jianweizou/count-display/FAE/计数器问题测试报告.docx

# 计数器问题测试报告

问题：外部表现是充电时，按键后OLED无任何显示

测试：

1、通过对测试样品进行充电测试，发现电路有140mA，并且伴随有充电IC（丝印LTH7）发热现象，怀疑是充电IC损坏；

2、 在购买一些TP4054充电IC后，进行替换后，所有测试样品都能正常充电；
3、 在2中替换后，有部分样品工作正常（标记B），有部分没有显示（标记A），电池电压均正常；
4、 对调工作正常和不正常的OLED后，结果依然是可以显示的OLED能显示，不能的依然不行；初步怀疑是OLED FPC折断。
