jianweizou/count-display/doc/计数器.pdf

# 佛珠計數器顯示介面

K 三 WA

# 開机劃面 1 ，顯示二秒然後自動跳到 2

1

2 中文 /ENGLISH 長短選定中文跳至 2-2 ，短按跳至 ENGLISH 長按選定 ENGLISH 跳至 3-2

# 2 中文顯示介面

2-2 | 2018/01/01 23:59 | 2018 閃爍，短按一下就跳 2019 年，長按 2 秒選定後跳至 月 01 按 一下就跳 02 ，長按 2 秒選定後跳至 日 01 按一下就跳 02 ，長按 2 秒選定後跳至 2-3
2-4 | 數字 / 藏文數字 長按選定數字 跳至 2-9 ，短按一下跳 藏文數字 長按 2 秒選定後跳至 2-
| 9 。

日期時間正確
是 / 否
2-3 | 長按選定 是 跳至 2-4 ，短按一下跳 否 長按 2 秒選定 否 跳至
| 2-2 ，

# 阿拉伯與 阿拉伯數字與藏文數字對照，請見最後一頁

# 2 中文顯示介面

2-9

# 歸零 是 / 否 重置 是 / 否

計數模式下， 3 秒內無動作，自動關閉屏目 , 五分鐘無動作， 整体待机到最小功秏。 在關閉屏目或待机下，按一下按鍵回復並點亮屏目，同步計數

加 1

2-14

2-13

2-12

2-11

# 計數模式下長按 12 秒不放會自動出現 重置 是 / 否 的劃面 長按 是 跳至 1 重新設置，短按跳至 否 長按選定 否 跳回

2-12.

計數模式下長按 5 秒不放會自動出現 歸零 是 / 否 的劃面， 長按選定 是 累計數歸零並跳至 2-9 ，短按跳 否 長按選定 否 跳回 2-12

2018/01/01
TOTAL:00001

2018/01/01
TOTAL:00002

計數開始，屏目顯示日期跟數字，從 0 開始每按一下跳 1 累計。

# 2 英文顯示介面

3-2 | 2018/01/01 | 2018 閃爍，按一下跳 2019 ，長按 2 秒選定後跳至 月 01 按一下就 跳 02 ，長按 2 秒選定後跳至 日 01 按一下就跳 02 ，長按 2 秒選定 後跳至 3-3
3-4 | NORMAL/TIBETAN | 長按選定 NORMAL 跳至 3-9 ，短按跳 TIBETAN ，長按 2 秒選定 TIBETAN 後跳至 3-9 。
3-3 | DATE YES/NO | 長按選定 YES 跳至 3-4 ， 短按跳 NO 長按 2 秒選定 NO 跳至 3-2 重新設定日期

# 2 英文顯示介面

2018/01/01

TOTAL:00001 3-9 | 計數開始，屏目顯示 日期跟數字，從 0 開始每按一下跳 1 累

計。

RESET COUNT
YES/NO

RESET DEVICE
YES/NO

計數模式下， 3 秒內無動作，並關閉屏目 , 五分鐘無動作，整 体待机到最小功秏。

在關閉屏目或待机下，按一下按鍵回復，出現屏目並計數加 1

3-14

3-13

3-12

3-11

2018/01/01
TOTAL:00002 | 計數下長按 5 秒不放會自動出現 RESET COUNT YES/NO 的
| 劃面，長按選定 YES 累計數歸零並跳至 3-9 ，短按跳 NO 長按選定 NO 跳回 3-12 計數下長按 12 秒不放會自動出現 RESET DEVICE YES/NO 的劃面 長按 YES 跳至 1 重新設置裝置，短按跳 NO 長

按選定 NO 跳回 2-12.

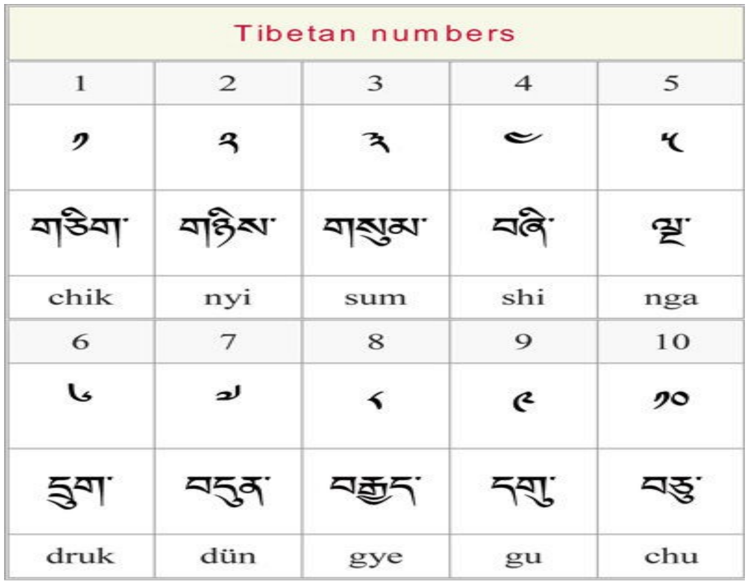
[picture p6: page 6]
