jianweizou/count-display/doc/Counter+ME+BOM+list+20180106.pptx

Mechanical Parts
BOM and material description

## Slide 2

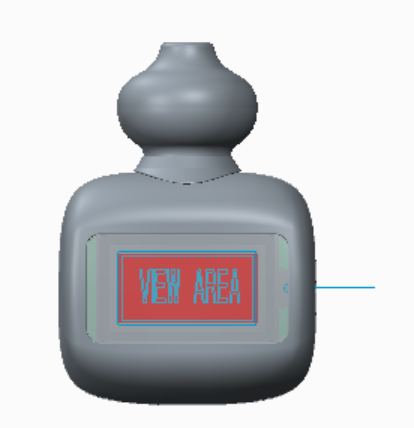
[picture p7: figure]
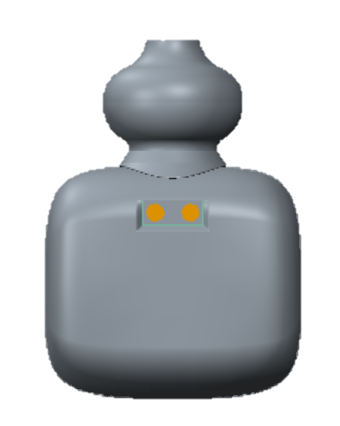
[picture p8: figure]
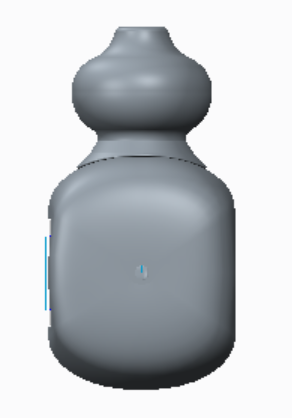
[picture p9: figure]

## Slide 3

Counter head
金屬皇冠

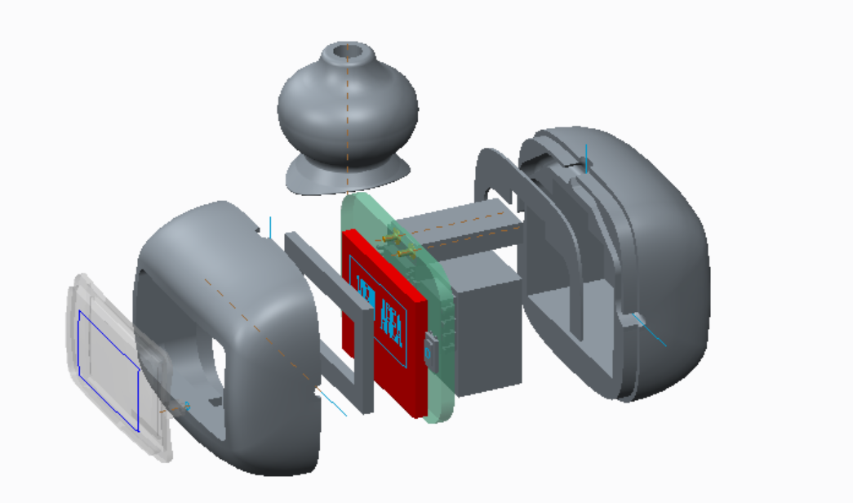
[picture p10: figure]

0.3 mm Film with adhesive
0.3 薄片含背膠

Back cover
金屬背蓋

EE components
電子零件

Sponge
1.0mm 泡棉

Front cover
金屬前框

PC Lens with Switch
PC 面板含按鍵功能

** 前後蓋點膠黏死完成組裝

## Slide 4

** 穿線路徑

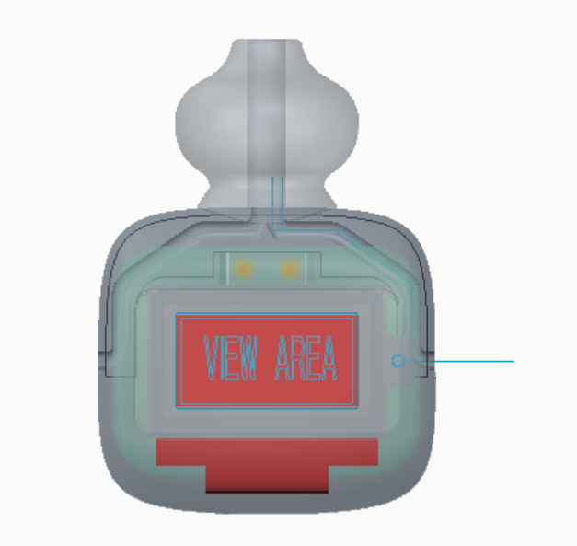
[picture p11: figure]

## Slide 5

PC Lens with Switch
PC 面板含按鍵功能

3.6 mm

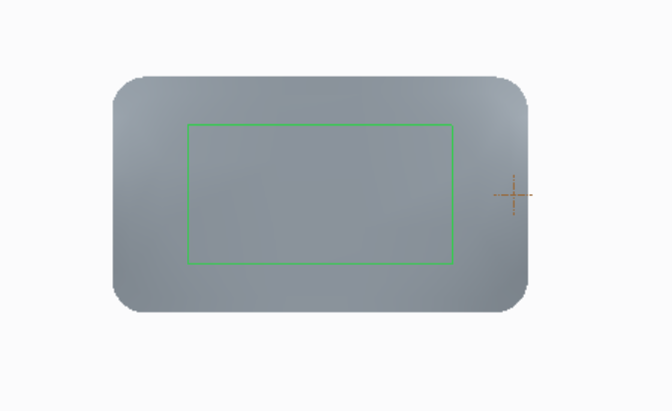
[picture p12: figure]

11.78 mm

2.48 mm

6.18 mm

印刷黑色

透光區域

## Slide 6

Product Overview
And
EE components description

## Slide 7

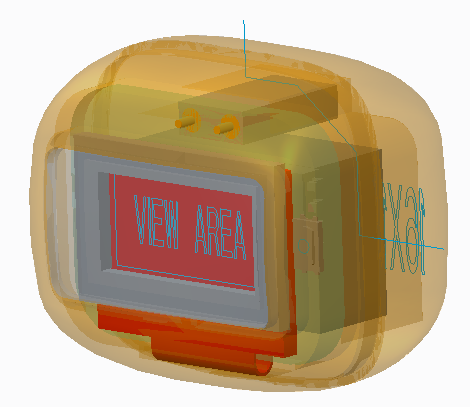
[picture p13: figure]
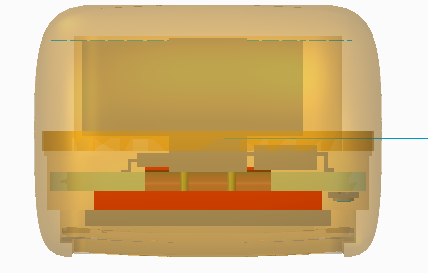
[picture p14: figure]

16mm

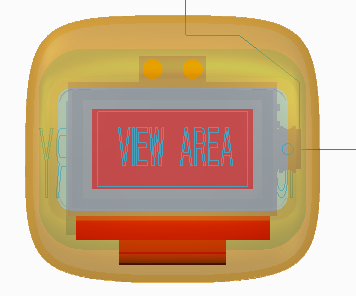
[picture p15: figure]
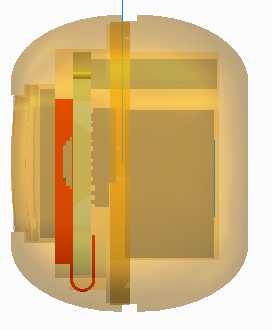
[picture p16: figure]

20mm

22mm

## Slide 8

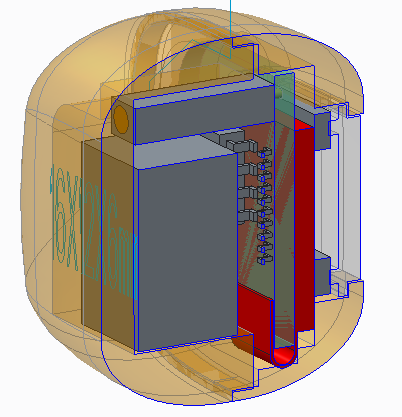
[picture p17: figure]

Side section

Charge connector

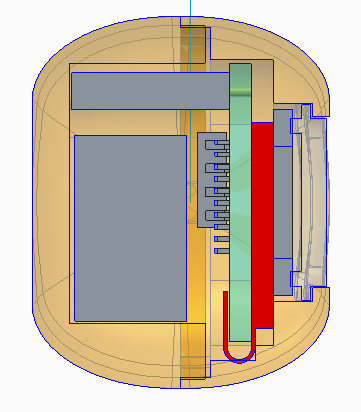
[picture p18: figure]

battery

lens

sponge

OLED

Space
2.3mm

PCB T1.2mm

## Slide 9

R3.3

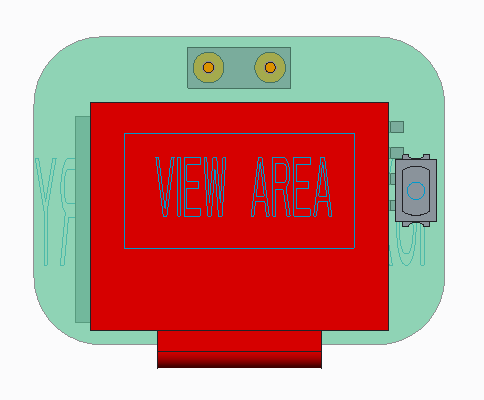
[picture p19: figure]

FRONT side

15mm

PCB T1.2mm

20 mm

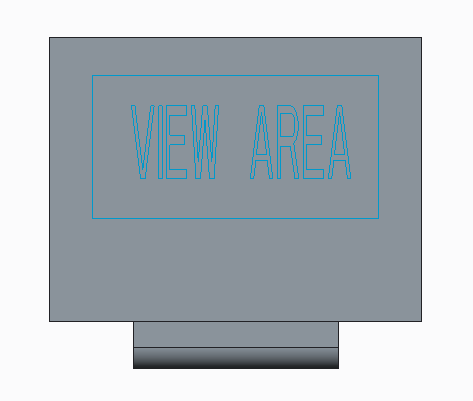
[picture p20: figure]
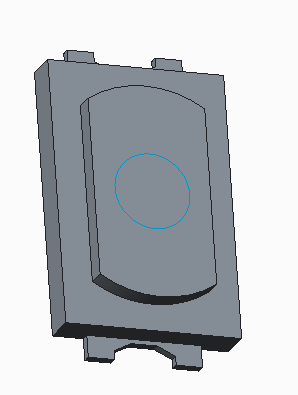
[picture p21: figure]

11.1mm

Switch

OLED 0.49inch
T1.2mm

E-switch
TL3780
www.e-switch.com

14.5mm

## Slide 10

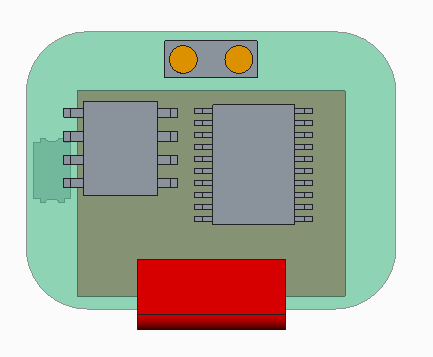
[picture p22: figure]
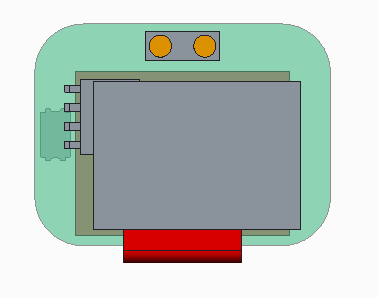
[picture p23: figure]

BACK side

Charge connector

N76E003

TP4056

ZIF connector

Battery cable

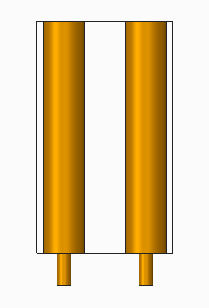
[picture p24: figure]

Battery

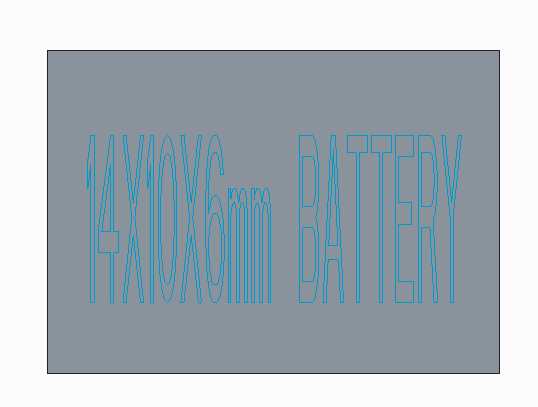
[picture p25: figure]

D 1.5 mm

10mm

10mm

Charge conn.

10mm

14.mm

2mm

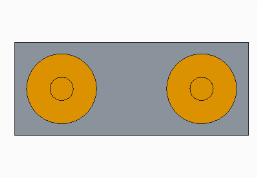
[picture p26: figure]

5mm

1.2mm

D 0.5mm

Battery H 6.0mm
Max 7.0 mm

Pitch 3.0mm
