jianweizou/count-display/layout/N76E003_V3.5_181220/N76E003_V3.5_BOM List.xls

N76E003_V3.5_BOM
Designator | Comment | Footprint | Description | Quantity
C1, C4 | 10uF | C-0402 | 贴片电容 | 2
C5, C6, C7, C8, C9, C10, C11, C12 | 0.1uF | C-0402 |  | 8
R1, R2, R9, R10 | 50k | R-0402 | 贴片电阻 | 4
R3 | 10k | R-0402 |  | 1
R4, R5 | 100K | R-0402 |  | 2
R6 | 300K | R-0402 |  | 1
R7, R8, | 4.7K | R-0402 |  | 2
SW1 | PUSH BOTTOM (B) | SWITCH | E-Switch按键 | 1
U1 | N76E003AQ20 | QFN-20 | 主控 | 1
U2 | TP4054 | SOT-23-5 | 充电IC | 1
U3 | PT5110E_SOT23 | SOT-23 | 稳压IC | 1
J1 | OLED-0.49 | OLED-0.49 | OLED | 1
JP1 | HEADER 2 | HED 1X2 2.84MM | 充电铜空间距2.84mm | 1
JP2 | P2-2.54mm | HED1X2 | 电池插座 | 1
