jianweizou/count-display/layout/N76E003_V3.4_181108/N76E003_V3.4_BOM List.xls

N76E003_V3.3_BOM
Designator | Comment | Footprint | Description | Quantity
C1, C4, C5 | 10uF | C-0402 | 贴片电容 | 3
C2, C6, C7, C9, C11 | 0.1uF | C-0201 |  | 5
C3, C8, C10 | 1uF | C-0201 |  | 3
R1, R9,R10 | 50k | R-0201 | 贴片电阻 | 3
R3 | 10k | R-0201 |  | 1
R2 | 47K | R-0201 |  | 1
R4, R5 | 1M | R-0201 |  | 2
R6 | 300K | R-0201 |  | 1
R7, R8, | 4.7K | R-0201 |  | 2
SW1 | PUSH BOTTOM (B) | SWITCH | E-Switch按键 | 1
U1 | N76E003AQ20 | QFN-20 | 主控 | 1
U2 | TP4054 | SOT-23-5 | 充电IC | 1
U3 | PT5110E_SOT23 | SOT-23 | 稳压IC | 1
J1 | OLED-0.49 | OLED-0.49 | OLED | 1
JP1 | HEADER 2 | HED 1X2 2.84MM | 充电铜空间距2.84mm | 1
JP2 | P2-2.54mm | HED1X2 | 电池插座 | 1
