jianweizou/count-display/doc/Counter_BOOM.xlsx

Bill of Material for
On 2018-2-21 at 16:33:23
Comment | Pattern | Quantity | Components
0.34V | 1206D | 1 | D3
0.4 | 402 | 1 | R6 | small resistor
102 | 0603C | 1 | C5
104 | 0603C | 2 | C4, C6
10K | RES_0402_SMD | 2 | R1, R4 | Resistor
10U | 0805P | 1 | C1
10uF | 0603C | 2 | C2, C3
1K | 402 | 5 | R5, R7, R8, R9, Rprog | small resistor
1K | RES_0402_SMD | 2 | R2, R3 | Resistor
Header 2H | HDR1X2H | 1 | P3 | Header, 2-Pin, Right Angle
Header 5X2 | HDR2X5 | 1 | P2 | Header, 5-Pin, Dual row
Header 7 | HDR1X7 | 1 | P1 | Header, 7-Pin
LED | 0805P | 4 | D1, D2, D4, D5
Micro-USB | Micro-USB | 1 | J1
N76E003 TSSOP20 | TSSOP20 | 1 | 51MCU
switch | SWITCH-微型 | 2 | SW1, SW2
TP4056 SOP8 | SOP8 | 1 | Batter_Charge
OLED | HDR1X7 | 1 | Display
