jianweizou/count-display/layout/N76E003_V3.4_181108/N76E003_V3.4.DXF

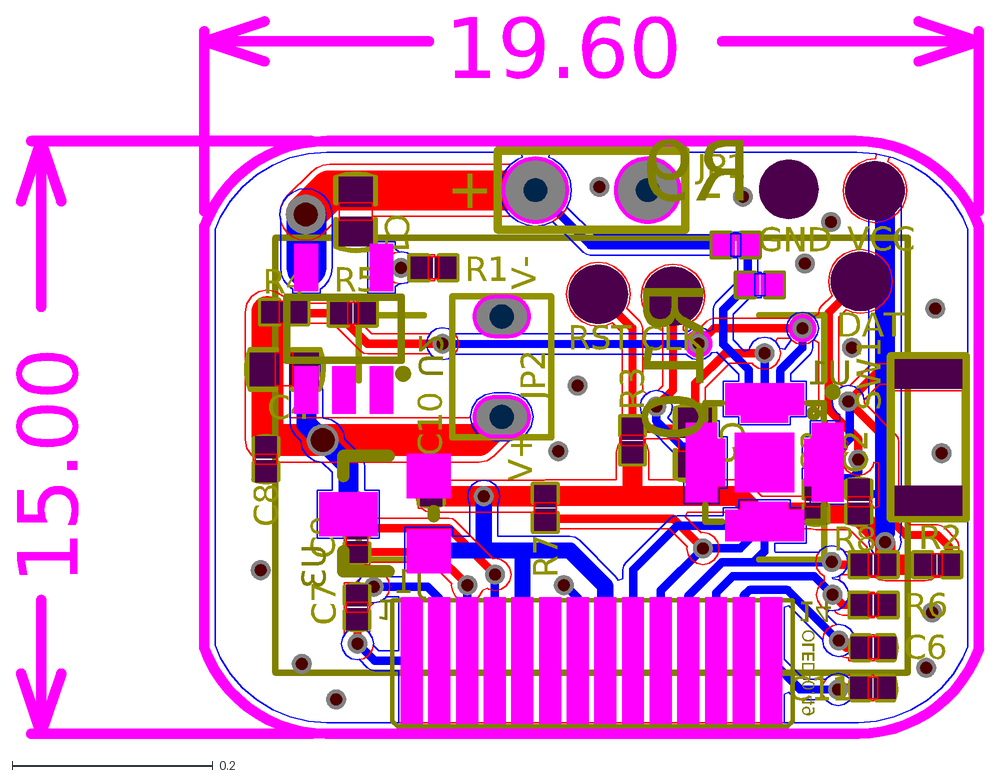
[picture p27: CAD file, 2019-02-22]
layout/N76E003_V3.4_181108/N76E003_V3.4.DXF
-
+
V+
V-
19.60
15.00
VCC
RST
GND
DAT
CLK
C5
C4
C1
C9
C7
SW1
C11
C10
C8
C6
C2
C3
R1
R2
R3
R4
R5
R6
R7
R8
JP2
JP1
U1
14
1
OLED-0.49
J1
U2
U3
R9
R10
