jianweizou/count-display/layout/N76E003_V3.5_181220/N76E003_V3.5.DXF

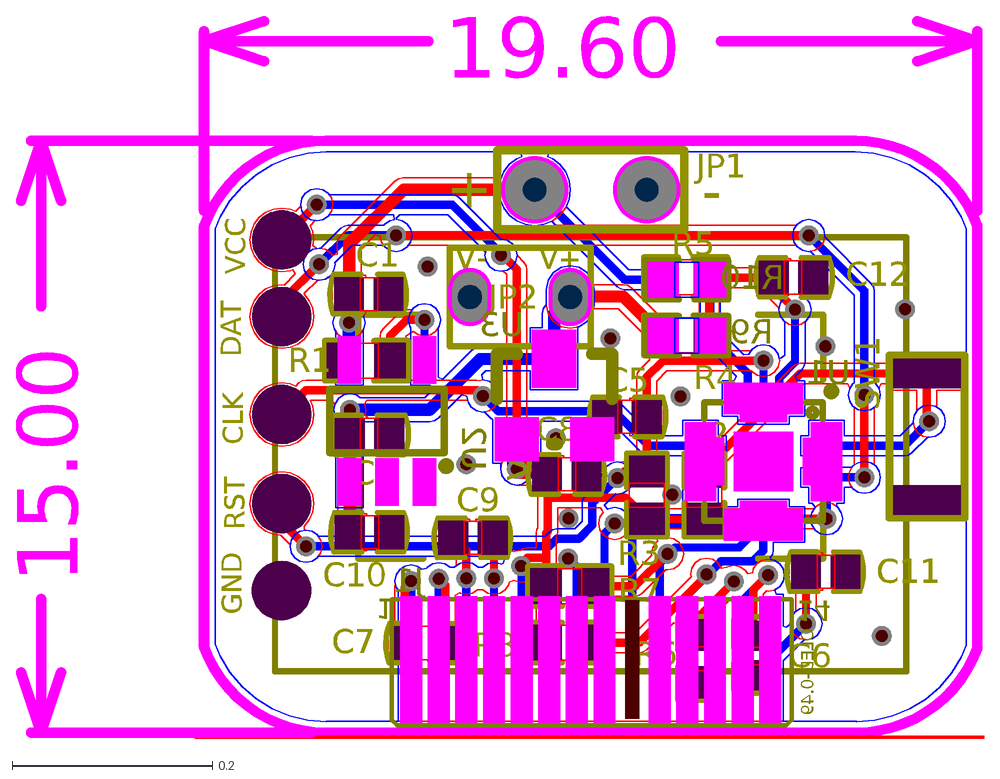
[picture p28: CAD file, 2019-02-22]
layout/N76E003_V3.5_181220/N76E003_V3.5.DXF
-
+
V+
V-
19.60
15.00
C11
C12
RST
DAT
CLK
VCC
GND
C5
C4
C1
C9
C7
SW1
C10
C8
C6
R1
R2
R3
R4
R5
R6
R7
R8
JP2
JP1
U1
14
1
OLED-0.49
J1
U2
U3
R9
R10
