jianweizou/count-display/(list of files, cad)

Other CAD files:
code/I2C_EEPROM_20181110/Output/main.obj
code/I2C_EEPROM/Output/main.obj
0.49 OLED/中景园电子0.49寸OLED模块资料/中景园电子0.49OLED显示屏_C51系列_IIC/main.OBJ
code/I2C_EEPROM_20190318/Output/main.obj
code/I2C_EEPROM_20190127/Output/main.obj
0.49 OLED/中景园电子0.49寸OLED模块资料/中景园电子0.49OLED显示屏_C51系列_IIC/oled.obj
code/I2C_EEPROM_20190127/Output/FontData.obj
code/I2C_EEPROM_20190318/Output/STARTUP.obj
0.49 OLED/中景园电子0.49寸OLED模块资料/中景园电子0.49OLED显示屏_C51系列_IIC/STARTUP.OBJ
code/I2C_EEPROM_20190127/Output/dataflash.obj
code/I2C_EEPROM_20190318/Output/FontData.obj
code/I2C_EEPROM_20190127/Output/OLED.obj
code/I2C_EEPROM_20190127/Output/STARTUP.obj
code/I2C_EEPROM_20190318/Output/count.obj
code/I2C_EEPROM_20190318/Output/OLED.obj
code/I2C_EEPROM_20190127/Output/count.obj
code/I2C_EEPROM_20190318/Output/i2c.obj
code/I2C_EEPROM_20190127/Output/i2c.obj
code/I2C_EEPROM_20190318/Output/dataflash.obj
code/I2C_EEPROM_20190318/Output/ds1302.obj
code/I2C_EEPROM_20190318/Output/Common.obj
code/I2C_EEPROM_20190318/Output/I2C_EEPROM.obj
code/I2C_EEPROM/Output/FontData.obj
code/I2C_EEPROM/Output/OLED.obj
code/I2C_EEPROM/Output/STARTUP.obj
code/I2C_EEPROM/Output/count.obj
code/I2C_EEPROM/Output/dataflash.obj
code/I2C_EEPROM/Output/i2c.obj
code/I2C_EEPROM_20181110/Output/FontData.obj
code/I2C_EEPROM_20181110/Output/OLED.obj
code/I2C_EEPROM_20181110/Output/STARTUP.obj
code/I2C_EEPROM_20181110/Output/count.obj
code/I2C_EEPROM_20181110/Output/dataflash.obj
code/I2C_EEPROM_20181110/Output/ds1302.obj
code/I2C_EEPROM_20181110/Output/i2c.obj
