jianweizou/count-display/0.49 OLED/ER-OLED0.49-1_Interfacing.pdf

## The Serial I2C Reference Example

## MCU

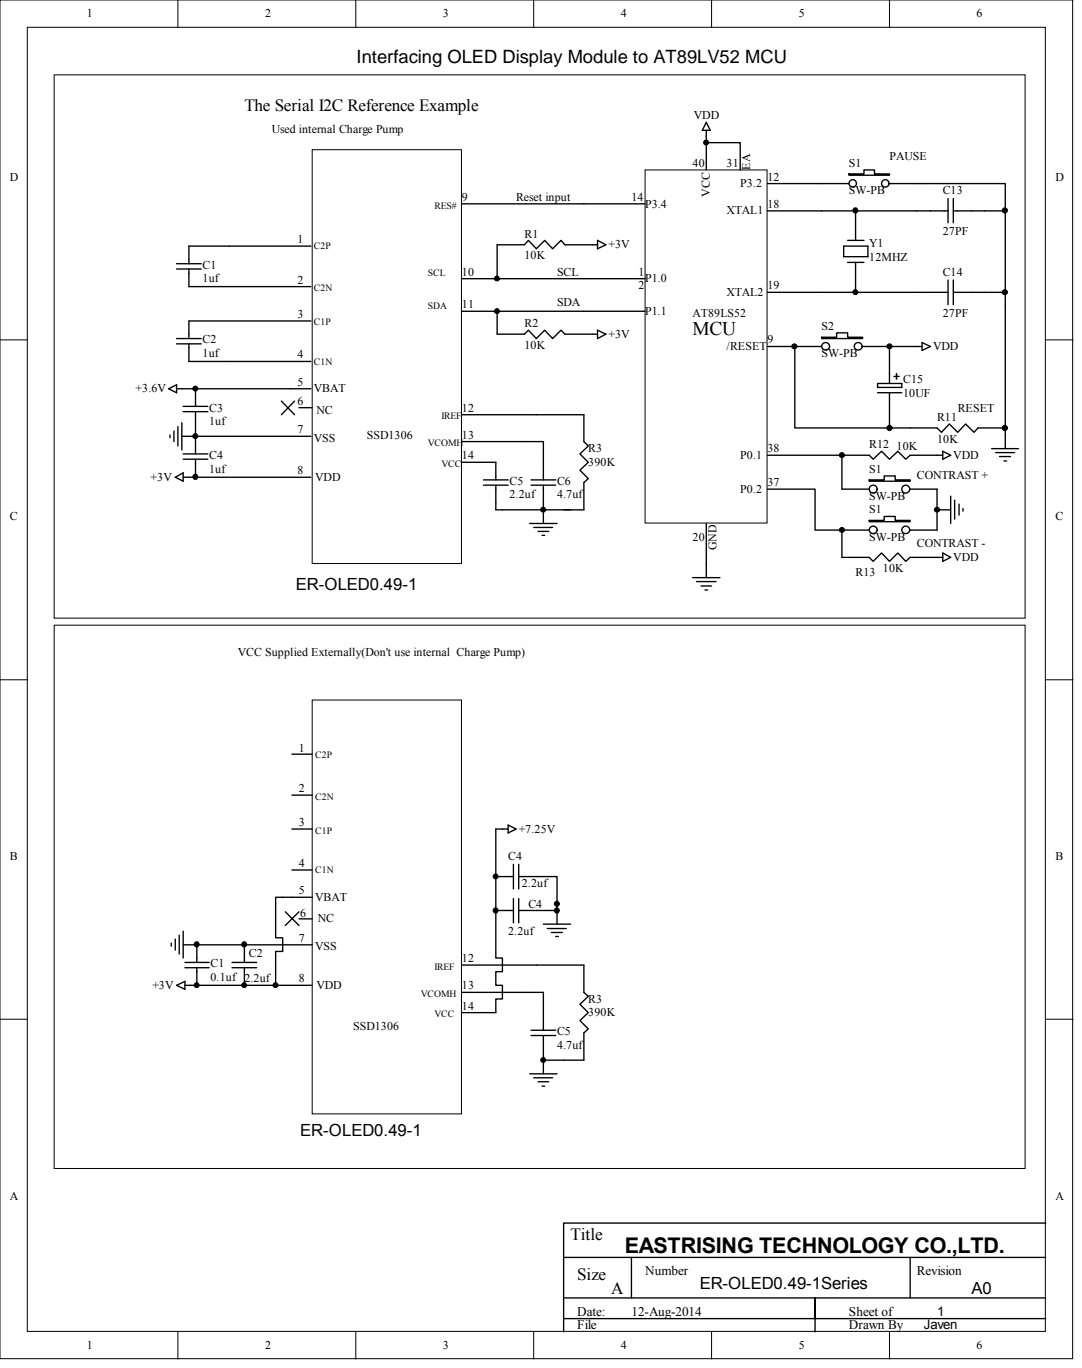
[picture p29: page 1]

Interfacing OLED Display Module to AT89LV52 MCU

Used internal Charge Pump

VCC Supplied Externally(Don't use internal Charge Pump)

Title
EASTRISING TECHNOLOGY CO.,LTD.
