jianweizou/count-display/layout/N76E003_V3.4_181108/N76E003_V3.4.pdf

# T P 4 0 5 6 - 1 A 锂电池充电电路

KEY | TICERSTP¹⁸ TICECLK KEY | GND | TICEDAT

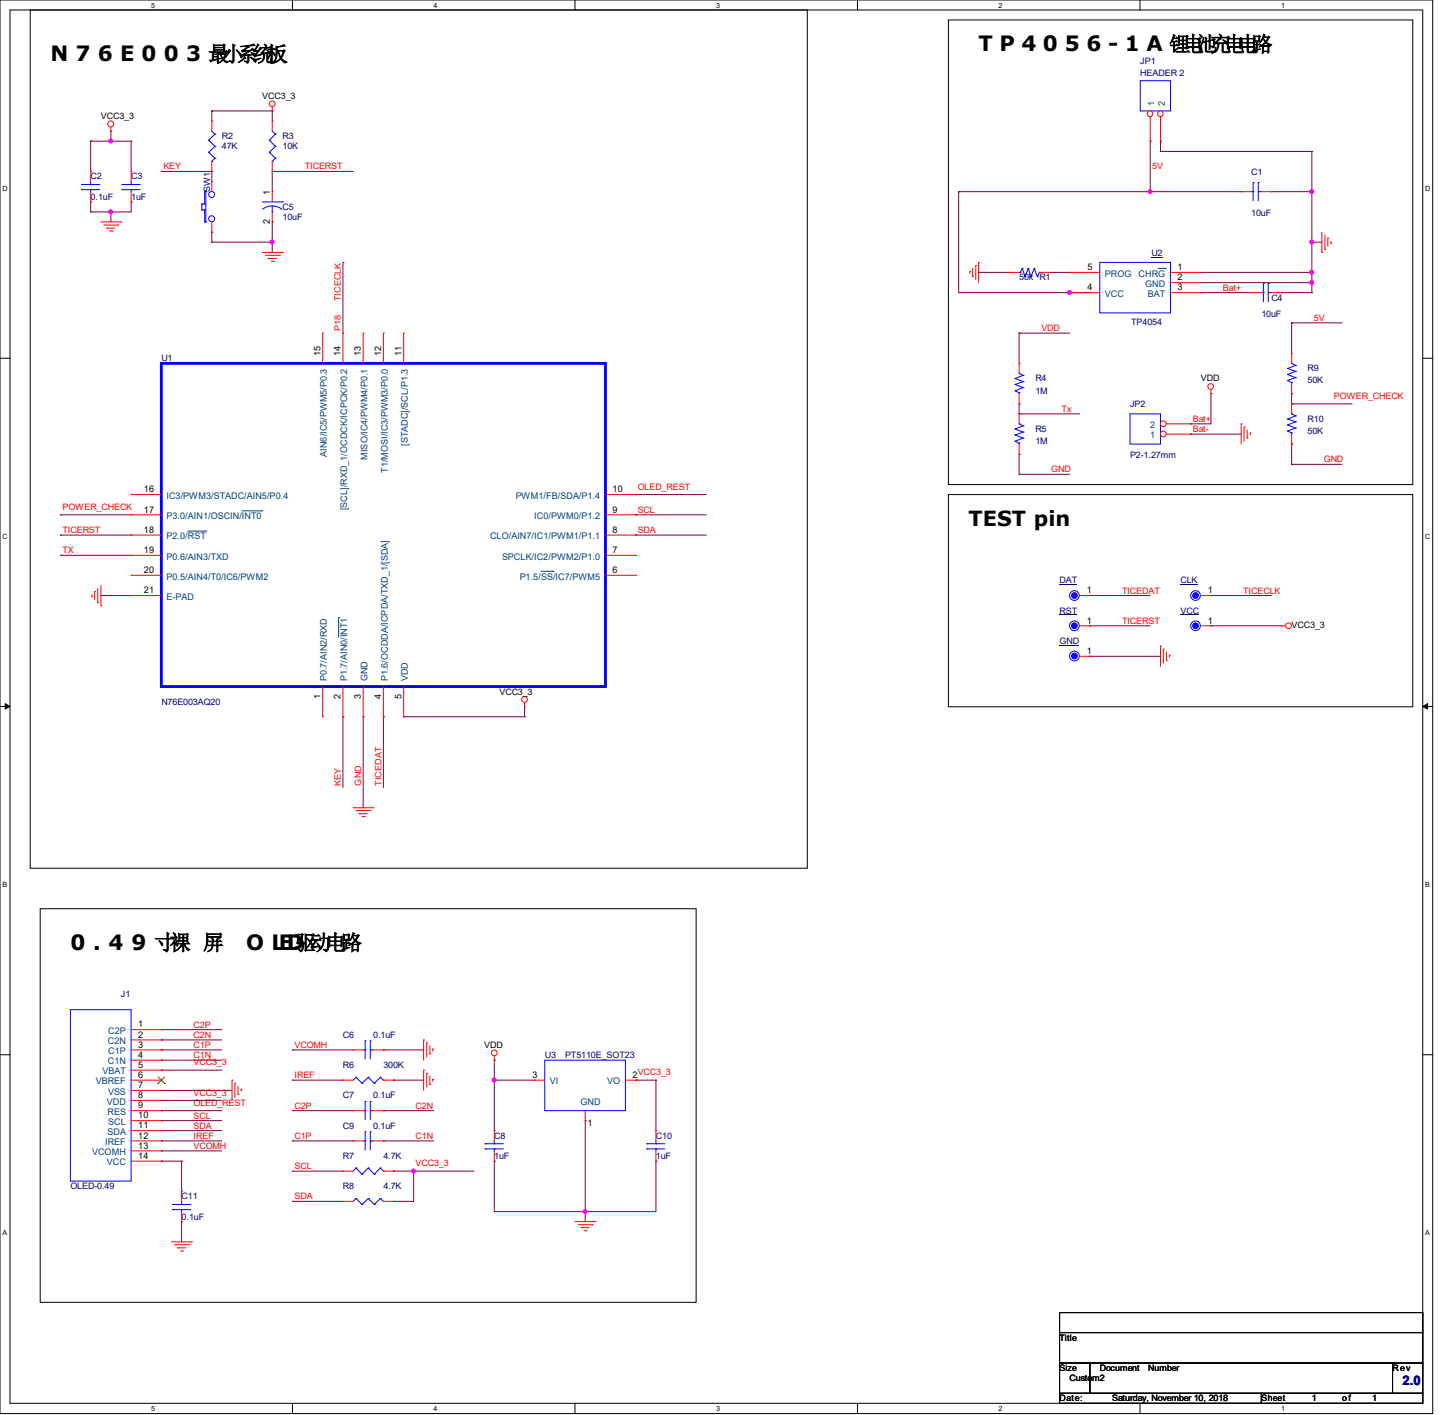
[picture p30: page 1]

5 P1.5/SS/IC7/PWM5 6 PWM1/FB/SDA/P1.4 10 AIN6/IC5/PWM5/P0.3 15 [STADC]/SCL/P1.3 11

3 P1.6/OCDDA/ICPDA/TXD_1/[SDA] 4 VDD
