jianweizou/count-display/layout/N76E003_V3.5_181220/N76E003_3.5.pdf

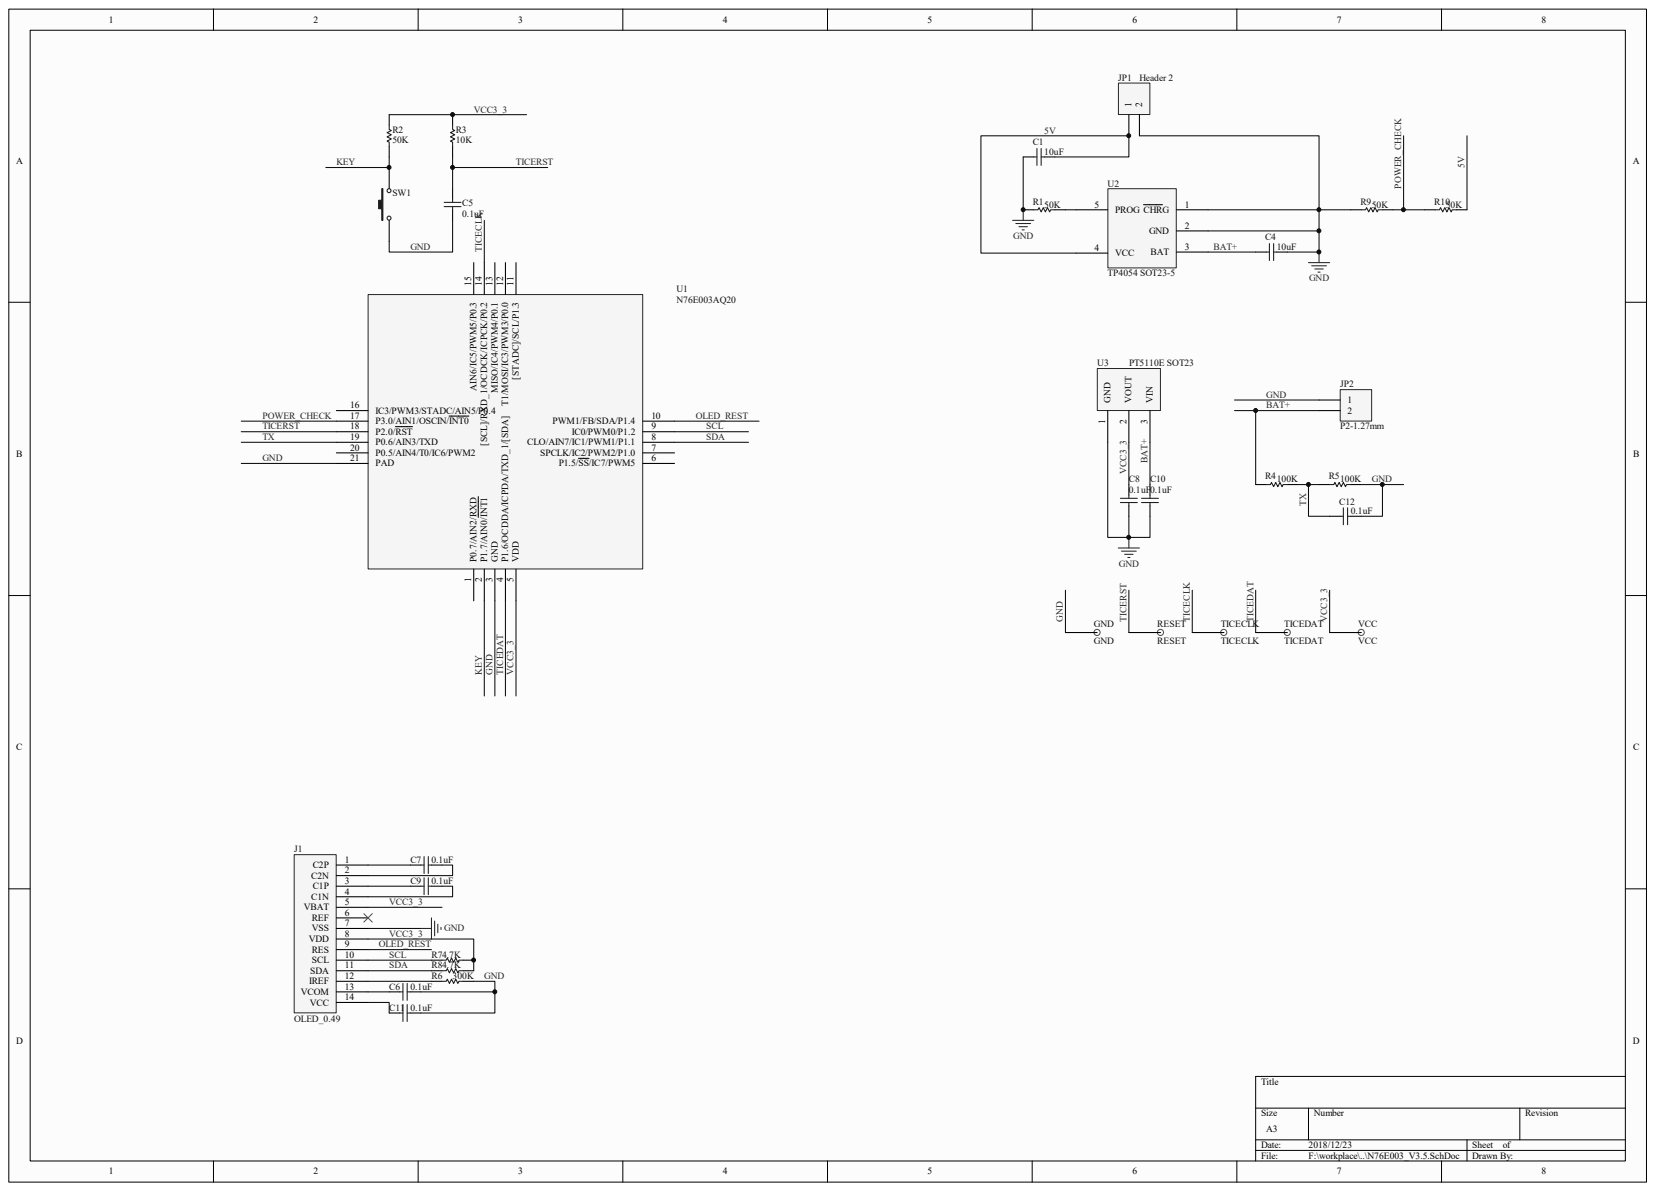
[picture p31: page 1]

3 P1.6/OCDDA/ICPDA/TXD_1/[SDA] 4 VDD

SDA KEY GND TICEDAT VCC³_3
