jianweizou/count-display/doc/Counter_Schematic.pdf

## 注意这里的电源画反了的，所以修改成这样

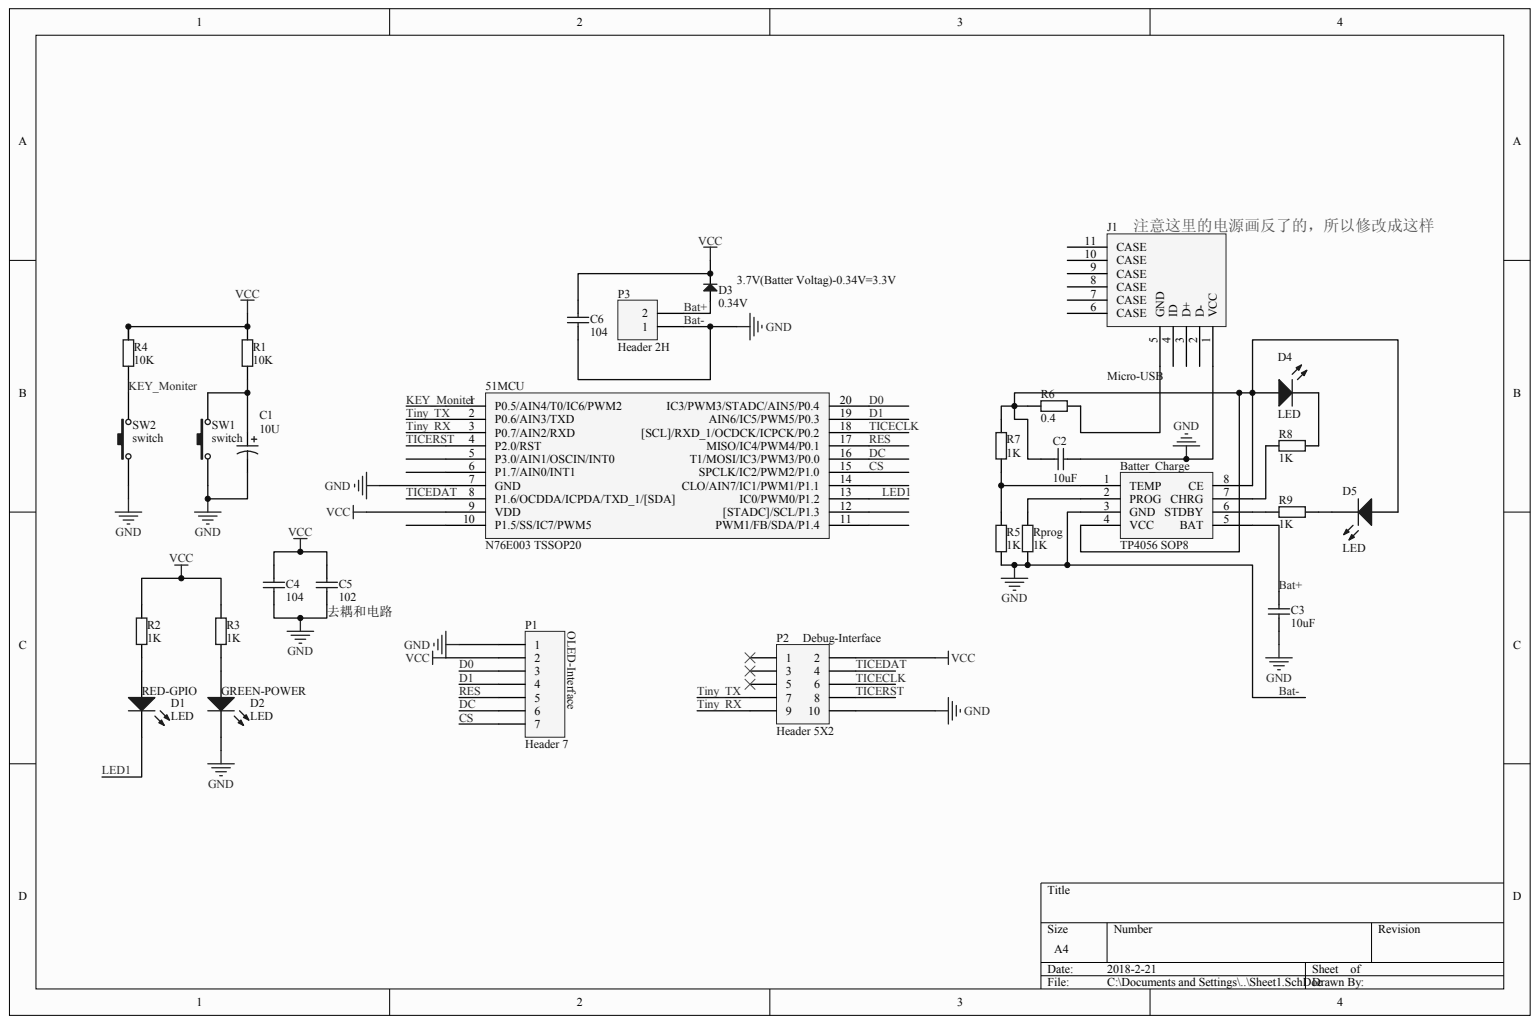
[picture p32: page 1]
