jianweizou/count-display/0.49 OLED/中景园电子0.49OLED原理图.pdf

# 0.49'' 164*32单色OLED驱动板

## Active Area 0.49''

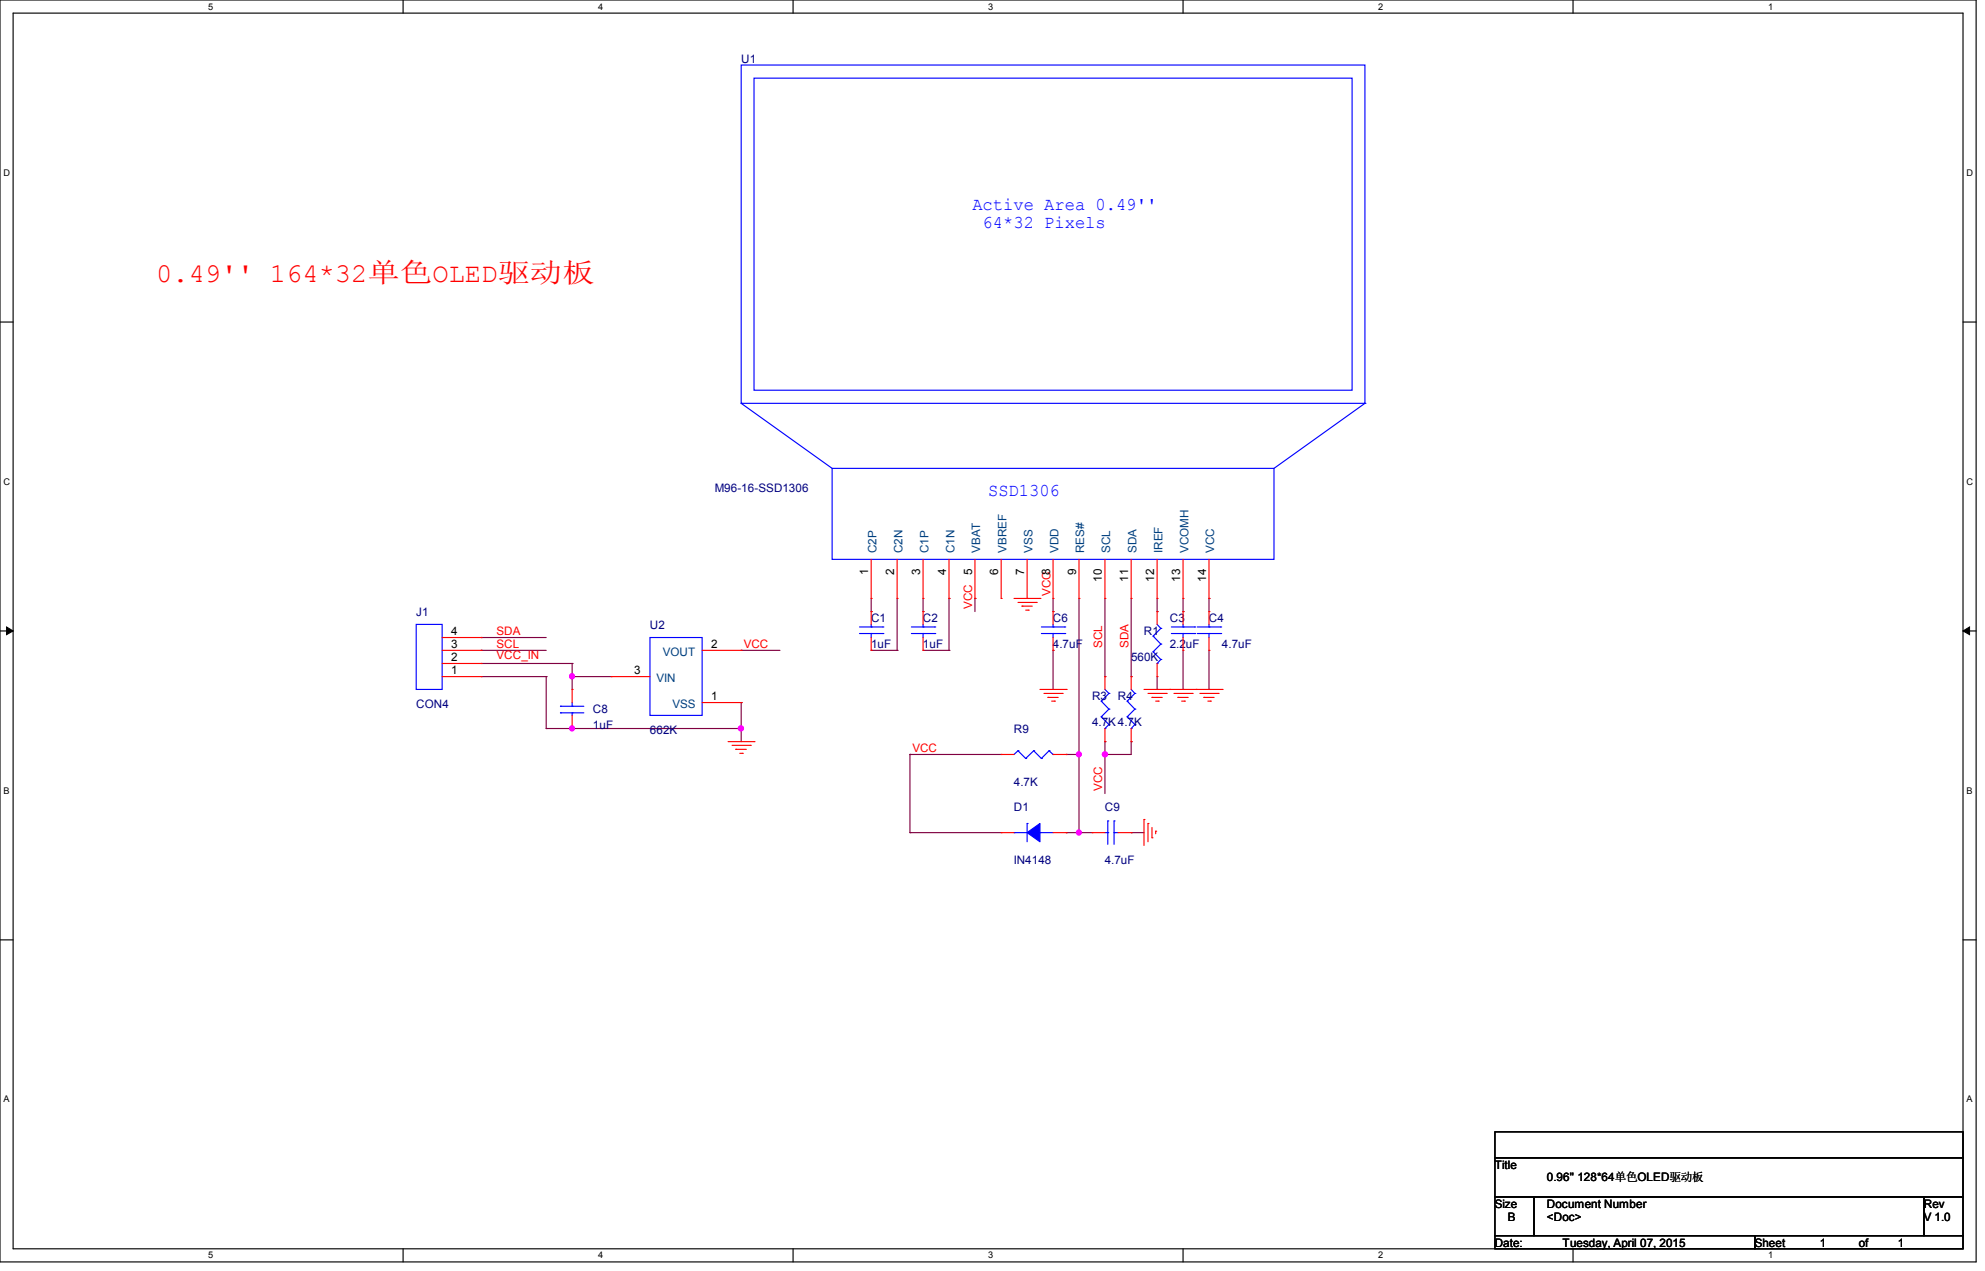
[picture p33: page 1]
