jianweizou/count-display/0.49 OLED/中景园电子0.49寸OLED模块资料/中景园电子0.49OLED显示屏模块结构图.pdf

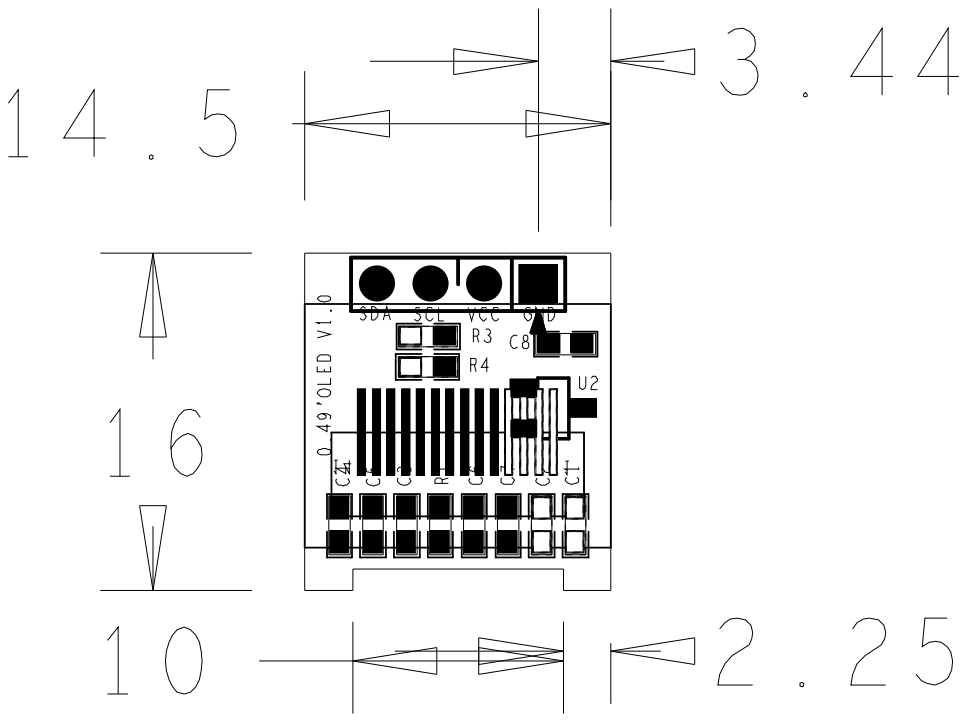
[picture p34: page 1]
