jianweizou/count-display/(list of files, drawings)

Other design files:
doc/PCB1.PcbDoc
doc/Sheet1.SchDoc
layout/N76E003_V3.4_181108/N76E003_V3.4.DSN
layout/N76E003_V3.4_181108/N76E003_V3.4.PcbDoc
layout/N76E003_V3.5_181220/N76E003_V3.5.PcbDoc
layout/N76E003_V3.5_181220/N76E003_V3.5.SchDoc
