jianweizou/count-display/0.49 OLED/中景园电子0.49寸OLED模块资料/M049_STM32F103ZET6_IIC_V1.0/USER/main.c

//////////////////////////////////////////////////////////////////////////////////	 
//本程序只供学习使用，未经作者许可，不得用于其它任何用途
//中景园电子
//店铺地址：http://shop73023976.taobao.com/?spm=2013.1.0.0.M4PqC2
//
//  文 件 名   : main.c
//  版 本 号   : v2.0
//  作    者   : Evk123
//  生成日期   : 2014-0101
//  最近修改   : 
//  功能描述   : 0.49寸OLED 接口演示例程(STM32F103ZE系列IIC)
//              说明: 
//              ----------------------------------------------------------------
//              GND   电源地
//              VCC   接5V或3.3v电源
//              SCL   接PD6（SCL）
//              SDA   接PD7（SDA）            
//              ----------------------------------------------------------------
//Copyright(C) 中景园电子2014/3/16
//All rights reserved
//////////////////////////////////////////////////////////////////////////////////

#include "delay.h"
#include "sys.h"
#include "oled.h"
#include "bmp.h"
 int main(void)
  {	u8 t;
		delay_init();	    	 //延时函数初始化	  
		OLED_Init();			//初始化OLED  
		OLED_Clear()  	; 

	while(1) 
	{		

	   OLED_ShowString(0,0,"0.49OLED",8);
		 OLED_ShowString(0,1,"12345678",8);
		 OLED_ShowString(0,2,"12345678",8);
		OLED_ShowString(0,3,"12345678",8);
			delay_ms(1000);
	  	delay_ms(1000);
	  	delay_ms(1000);
	 	  OLED_Clear();
			OLED_ShowString(0,0,"0.49OLED",8);
		 OLED_ShowString(0,1,"12345678",8);
  	 OLED_ShowString(0,2,"12345678",16);
			delay_ms(1000);
	  	delay_ms(1000);
	  	delay_ms(1000);
	 	  OLED_Clear();
		OLED_ShowCHinese(8,0,0);//中
		OLED_ShowCHinese(24,0,1);//景
		OLED_ShowCHinese(40,0,2);//园
		OLED_ShowCHinese(8,2,7);//超
		OLED_ShowCHinese(40,2,8);//亮
			delay_ms(1000);
	  	delay_ms(1000);
	  	delay_ms(1000);
			OLED_Clear();
		OLED_DrawBMP(0,0,64,4,BMP1);
			delay_ms(1000);
			delay_ms(1000);
	  	delay_ms(1000);
			 OLED_Clear();

	}	  
	
}
