jianweizou/count-display/0.49 OLED/中景园电子0.49寸OLED模块资料/M049_STM32F103ZET6_IIC_V1.0/HARDWARE/OLED/bmp.h

//////////////////////////////////////////////////////////////////////////////////	 
//
//
//存储图片数据，图片大小为64*32像素
//
/////////////////////////////////////////////////////////////////////////////////

#ifndef __BMP_H
#define __BMP_H
unsigned char BMP1[] =
{
0xFF,0x0B,0xFF,0x0B,0xC7,0x01,0xE1,0x01,0xF1,0x01,0xF9,0x01,0x01,0xFF,0x7D,0xBB,
0xC7,0xEF,0xEF,0xEF,0xEF,0xEF,0xEF,0xEF,0xC7,0xBB,0x7D,0xFF,0x01,0x01,0x01,0x01,
0x01,0x01,0x09,0x0D,0xFF,0xFF,0x0D,0x09,0x21,0x61,0xFF,0xFF,0x61,0x21,0x01,0x79,
0x49,0xFF,0x83,0xBB,0xBB,0x83,0xBB,0xBB,0x83,0xBB,0xBB,0x83,0xBB,0xBB,0x83,0xFF,
0xFF,0x00,0x00,0x00,0x00,0x00,0x00,0xFC,0x04,0x04,0x04,0x04,0x04,0x04,0x05,0xF5,
0x05,0x05,0x05,0x05,0x05,0x05,0x05,0x05,0x05,0x05,0x05,0xF4,0x54,0x54,0x54,0x54,
0x54,0x54,0x54,0xF4,0x04,0x04,0x04,0x04,0x04,0xE4,0x24,0x24,0xA4,0xA4,0xA4,0xA4,
0xA4,0xA4,0xA4,0x24,0x24,0xE4,0x04,0x04,0xFC,0x00,0x00,0x00,0x00,0x00,0x00,0xFF,
0xFF,0x00,0x00,0x00,0x00,0x00,0x00,0xFF,0x00,0x00,0xFF,0x41,0x41,0x41,0x41,0xFF,
0x41,0x41,0x41,0x41,0xFF,0x00,0x00,0x00,0x04,0x04,0x04,0xF5,0x95,0x95,0x95,0x97,
0x95,0x95,0x95,0xF5,0x04,0x04,0x04,0x00,0x00,0xFF,0x00,0x04,0xC4,0x3C,0x04,0x04,
0xFC,0x04,0x04,0xC4,0x00,0xFF,0x00,0x00,0xFF,0x00,0x00,0x00,0x00,0x00,0x00,0xFF,
0xFF,0x80,0x80,0x80,0x80,0x80,0x80,0xBF,0xA0,0xA0,0xA0,0xA0,0xA0,0xA0,0xA0,0xAF,
0xA0,0xA0,0xA0,0xA0,0xA0,0xA0,0xA0,0xA0,0xA0,0xA4,0xA2,0xA0,0xA0,0xA4,0xA8,0xA7,
0xA0,0xA0,0xA0,0xA0,0xA2,0xA4,0xA0,0xA0,0xA0,0xAF,0xA4,0xA5,0xA4,0xA4,0xA4,0xA4,
0xA4,0xA5,0xA5,0xA5,0xA4,0xAF,0xA0,0xA0,0xBF,0x80,0x80,0x80,0x80,0x80,0x80,0xFF,/*"C:\Users\evk\Desktop\??\049??.bmp",0*/
};

#endif
