jianweizou/count-display/(commit log)

2019-02-22 计数器 first push
    [Common.obj, Counter_BOOM.xlsx, FontData.obj, I2C_EEPROM.obj, N76E003_V3.4.DSN, N76E003_V3.4.DXF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]
2019-02-22 update BOM list
    [N76E003_V3.5_BOM List.xls]
2019-02-22 update layout/N76E003_V3.5_181220.7z BOM list
2019-02-24 update system
    [count.obj]
2019-03-10 update 20190310 for I2C_EEPROM_20190127
    [FontData.obj, OLED.obj, STARTUP.obj, count.obj, dataflash.obj, i2c.obj, main.obj]
2019-03-18 update system FLASH->EEPROM, code data 减小等
    [Common.obj, FontData.obj, I2C_EEPROM.obj, OLED.obj, STARTUP.obj, count.obj, dataflash.obj, ds1302.obj]
