jianweizou/count-display/(notices)

Notices in the files:
0.49 OLED/中景园电子0.49寸OLED模块资料/M049_STM32F103ZET6_IIC_V1.0/HARDWARE/OLED/oled.h:
Copyright(C) ÖÐ¾°Ô°µç×Ó2014/3/16
All rights reserved
